dzervas/lab68/lab68.kicad_pcb

## KiCad design lab68.kicad_pcb (2020-12-09)

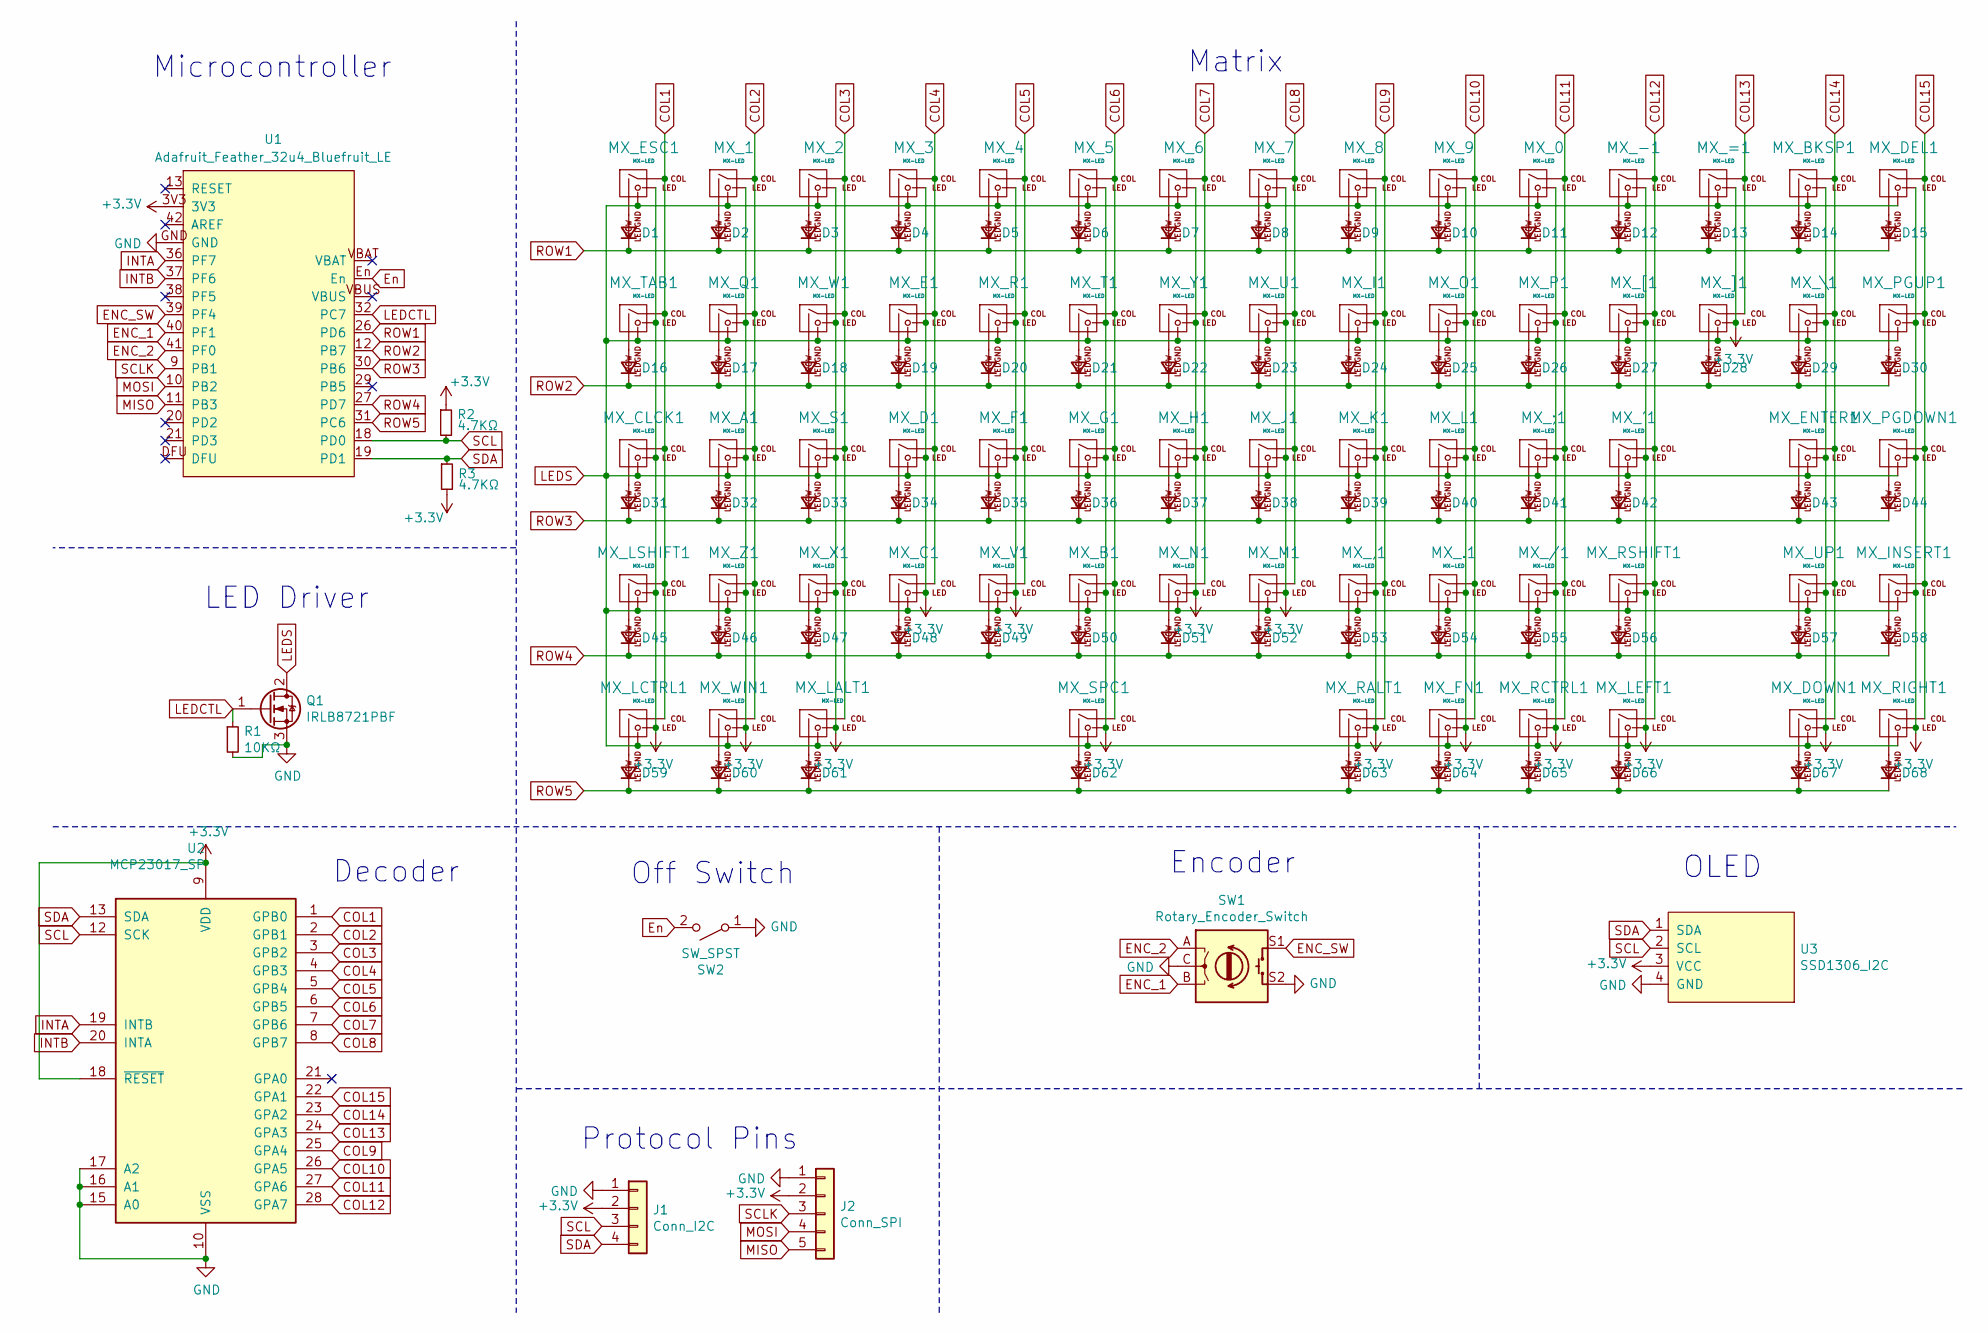
[picture p1: schematic lab68.sch]

Parts:
D1, D2, D3, D4, D5, D6, D7, D8, D9, D10, D11, D12, D13, D14, D15, D16, D17, D18, D19, D20, D21, D22, D23, D24, D25, D26, D27, D28, D29, D30, D31, D32, D33, D34, D35, D36, D37, D38, D39, D40, D41, D42, D43, D44, D45, D46, D47, D48, D49, D50, D51, D52, D53, D54, D55, D56, D57, D58, D59, D60, D61, D62, D63, D64, D65, D66, D67, D68: D_Small; D_DO-35_SOD27_P7.62mm_Horizontal
J1: Conn_I2C; JST_XH_B4B-XH-A_1x04_P2.50mm_Vertical
J2: Conn_SPI; JST_XH_B5B-XH-A_1x05_P2.50mm_Vertical
MX_0, MX_1, MX_2, MX_3, MX_4, MX_5, MX_6, MX_7, MX_8, MX_9, MX_.1: MX-LED; MXOnly-1U
MX_'1: MX-LED; MXOnly-1U
MX_,1: MX-LED; MXOnly-1U
MX_-1: MX-LED; MXOnly-1U
MX_/1: MX-LED; MXOnly-1U
MX_;1: MX-LED; MXOnly-1U
MX_=1: MX-LED; MXOnly-1U
MX_A1: MX-LED; MXOnly-1U
MX_B1: MX-LED; MXOnly-1U
MX_BKSP1: MX-LED; MXOnly-2U
MX_C1: MX-LED; MXOnly-1U
MX_CLCK1: MX-LED; MXOnly-1.75U
MX_D1: MX-LED; MXOnly-1U
MX_DEL1: MX-LED; MXOnly-1U
MX_DOWN1: MX-LED; MXOnly-1U
MX_E1: MX-LED; MXOnly-1U
MX_ENTER1: MX-LED; MXOnly-2.25U
MX_ESC1: MX-LED; MXOnly-1U
MX_F1: MX-LED; MXOnly-1U
MX_FN1: MX-LED; MXOnly-1U
MX_G1: MX-LED; MXOnly-1U
MX_H1: MX-LED; MXOnly-1U
MX_I1: MX-LED; MXOnly-1U
MX_INSERT1: MX-LED; MXOnly-1U
MX_J1: MX-LED; MXOnly-1U
MX_K1: MX-LED; MXOnly-1U
MX_L1: MX-LED; MXOnly-1U
MX_LALT1: MX-LED; MXOnly-1.25U
MX_LCTRL1: MX-LED; MXOnly-1.25U
MX_LEFT1: MX-LED; MXOnly-1U
MX_LSHIFT1: MX-LED; MXOnly-2.25U
MX_M1: MX-LED; MXOnly-1U
MX_N1: MX-LED; MXOnly-1U
MX_O1: MX-LED; MXOnly-1U
MX_P1: MX-LED; MXOnly-1U
MX_PGDOWN1: MX-LED; MXOnly-1U
MX_PGUP1: MX-LED; MXOnly-1U
MX_Q1: MX-LED; MXOnly-1U
MX_R1: MX-LED; MXOnly-1U
MX_RALT1: MX-LED; MXOnly-1U
MX_RCTRL1: MX-LED; MXOnly-1U
MX_RIGHT1: MX-LED; MXOnly-1U
MX_RSHIFT1: MX-LED; MXOnly-1.75U
MX_S1: MX-LED; MXOnly-1U
MX_SPC1: MX-LED; MXOnly-6.25U-ReversedStabilizers
MX_T1: MX-LED; MXOnly-1U
MX_TAB1: MX-LED; MXOnly-1.5U
MX_U1: MX-LED; MXOnly-1U
MX_UP1: MX-LED; MXOnly-1U
MX_V1: MX-LED; MXOnly-1U
MX_W1: MX-LED; MXOnly-1U
MX_WIN1: MX-LED; MXOnly-1.25U
MX_X1: MX-LED; MXOnly-1U
MX_Y1: MX-LED; MXOnly-1U
MX_Z1: MX-LED; MXOnly-1U
MX_[1: MX-LED; MXOnly-1U
MX_\1: MX-LED; MXOnly-1.5U
MX_]1: MX-LED; MXOnly-1U
Q1: IRLB8721PBF; TO-220-3_Horizontal_TabDown
R1: 10KΩ; R_Axial_DIN0207_L6.3mm_D2.5mm_P7.62mm_Horizontal
R2, R3: 4.7KΩ; R_Axial_DIN0207_L6.3mm_D2.5mm_P7.62mm_Horizontal
SW1: Rotary_Encoder_Switch; RotaryEncoder_Alps_EC11E-Switch_Vertical_H20mm
SW2: SW_SPST; SW_CuK_JS202011AQN_DPDT_Angled
U1: Adafruit_Feather_32u4_Bluefruit_LE
U2: MCP23017_SP; DIP-28_W7.62mm_Socket_LongPads
U3: SSD1306_I2C; OLED

Connections:
+3V3: J1.2, J2.2, MX_0.3 (LED), MX_1.3 (LED), MX_2.3 (LED), MX_3.3 (LED), MX_4.3 (LED), MX_5.3 (LED), MX_6.3 (LED), MX_7.3 (LED), MX_8.3 (LED), MX_9.3 (LED), MX_'1.3 (LED), MX_,1.3 (LED), MX_-1.3 (LED), MX_.1.3 (LED), MX_/1.3 (LED), MX_;1.3 (LED), MX_=1.3 (LED), MX_A1.3 (LED), MX_B1.3 (LED), MX_BKSP1.3 (LED), MX_C1.3 (LED), MX_CLCK1.3 (LED), MX_D1.3 (LED), MX_DEL1.3 (LED), MX_DOWN1.3 (LED), MX_E1.3 (LED), MX_ENTER1.3 (LED), MX_ESC1.3 (LED), MX_F1.3 (LED), MX_FN1.3 (LED), MX_G1.3 (LED), MX_H1.3 (LED), MX_I1.3 (LED), MX_INSERT1.3 (LED), MX_J1.3 (LED), MX_K1.3 (LED), MX_L1.3 (LED), MX_LALT1.3 (LED), MX_LCTRL1.3 (LED), MX_LEFT1.3 (LED), MX_LSHIFT1.3 (LED), MX_M1.3 (LED), MX_N1.3 (LED), MX_O1.3 (LED), MX_P1.3 (LED), MX_PGDOWN1.3 (LED), MX_PGUP1.3 (LED), MX_Q1.3 (LED), MX_R1.3 (LED), MX_RALT1.3 (LED), MX_RCTRL1.3 (LED), MX_RIGHT1.3 (LED), MX_RSHIFT1.3 (LED), MX_S1.3 (LED), MX_SPC1.3 (LED), MX_T1.3 (LED), MX_TAB1.3 (LED), MX_U1.3 (LED), MX_UP1.3 (LED), MX_V1.3 (LED), MX_W1.3 (LED), MX_WIN1.3 (LED), MX_X1.3 (LED), MX_Y1.3 (LED), MX_Z1.3 (LED), MX_[1.3 (LED), MX_\1.3 (LED), MX_]1.3 (LED), R2.1, R3.2, U1.3V3, U2.9 (VDD), U2.18 (~RESET~), U3.3 (VCC)
COL1: MX_CLCK1.1 (COL), MX_ESC1.1 (COL), MX_LCTRL1.1 (COL), MX_LSHIFT1.1 (COL), MX_TAB1.1 (COL), U2.1 (GPB0)
COL2: MX_1.1 (COL), MX_A1.1 (COL), MX_Q1.1 (COL), MX_WIN1.1 (COL), MX_Z1.1 (COL), U2.2 (GPB1)
COL3: MX_2.1 (COL), MX_LALT1.1 (COL), MX_S1.1 (COL), MX_W1.1 (COL), MX_X1.1 (COL), U2.3 (GPB2)
COL4: MX_3.1 (COL), MX_C1.1 (COL), MX_D1.1 (COL), MX_E1.1 (COL), U2.4 (GPB3)
COL5: MX_4.1 (COL), MX_F1.1 (COL), MX_R1.1 (COL), MX_V1.1 (COL), U2.5 (GPB4)
COL6: MX_5.1 (COL), MX_B1.1 (COL), MX_G1.1 (COL), MX_SPC1.1 (COL), MX_T1.1 (COL), U2.6 (GPB5)
COL7: MX_6.1 (COL), MX_H1.1 (COL), MX_N1.1 (COL), MX_Y1.1 (COL), U2.7 (GPB6)
COL8: MX_7.1 (COL), MX_J1.1 (COL), MX_M1.1 (COL), MX_U1.1 (COL), U2.8 (GPB7)
COL9: MX_8.1 (COL), MX_,1.1 (COL), MX_I1.1 (COL), MX_K1.1 (COL), MX_RALT1.1 (COL), U2.25 (GPA4)
COL10: MX_9.1 (COL), MX_.1.1 (COL), MX_FN1.1 (COL), MX_L1.1 (COL), MX_O1.1 (COL), U2.26 (GPA5)
COL11: MX_0.1 (COL), MX_/1.1 (COL), MX_;1.1 (COL), MX_P1.1 (COL), MX_RCTRL1.1 (COL), U2.27 (GPA6)
COL12: MX_'1.1 (COL), MX_-1.1 (COL), MX_LEFT1.1 (COL), MX_RSHIFT1.1 (COL), MX_[1.1 (COL), U2.28 (GPA7)
COL13: MX_=1.1 (COL), MX_]1.1 (COL), U2.24 (GPA3)
COL14: MX_BKSP1.1 (COL), MX_DOWN1.1 (COL), MX_ENTER1.1 (COL), MX_UP1.1 (COL), MX_\1.1 (COL), U2.23 (GPA2)
COL15: MX_DEL1.1 (COL), MX_INSERT1.1 (COL), MX_PGDOWN1.1 (COL), MX_PGUP1.1 (COL), MX_RIGHT1.1 (COL), U2.22 (GPA1)
ENC_1: SW1.B, U1.40 (PF1)
ENC_2: SW1.A, U1.41 (PF0)
ENC_SW: SW1.S1, U1.39 (PF4)
En: SW2.2 (B), U1.En
GND: J1.1, J2.1, Q1.3 (S), R1.2, SW1.C, SW1.S2, SW2.1 (A), U1.GND, U2.10 (VSS), U2.15 (A0), U2.16 (A1), U2.17 (A2), U3.4 (GND)
INTA: U1.36 (PF7), U2.19 (INTB)
INTB: U1.37 (PF6), U2.20 (INTA)
LEDCTL: Q1.1 (G), R1.1, U1.32 (PC7)
LEDS: MX_0.4 (LEDGND), MX_1.4 (LEDGND), MX_2.4 (LEDGND), MX_3.4 (LEDGND), MX_4.4 (LEDGND), MX_5.4 (LEDGND), MX_6.4 (LEDGND), MX_7.4 (LEDGND), MX_8.4 (LEDGND), MX_9.4 (LEDGND), MX_'1.4 (LEDGND), MX_,1.4 (LEDGND), MX_-1.4 (LEDGND), MX_.1.4 (LEDGND), MX_/1.4 (LEDGND), MX_;1.4 (LEDGND), MX_=1.4 (LEDGND), MX_A1.4 (LEDGND), MX_B1.4 (LEDGND), MX_BKSP1.4 (LEDGND), MX_C1.4 (LEDGND), MX_CLCK1.4 (LEDGND), MX_D1.4 (LEDGND), MX_DEL1.4 (LEDGND), MX_DOWN1.4 (LEDGND), MX_E1.4 (LEDGND), MX_ENTER1.4 (LEDGND), MX_ESC1.4 (LEDGND), MX_F1.4 (LEDGND), MX_FN1.4 (LEDGND), MX_G1.4 (LEDGND), MX_H1.4 (LEDGND), MX_I1.4 (LEDGND), MX_INSERT1.4 (LEDGND), MX_J1.4 (LEDGND), MX_K1.4 (LEDGND), MX_L1.4 (LEDGND), MX_LALT1.4 (LEDGND), MX_LCTRL1.4 (LEDGND), MX_LEFT1.4 (LEDGND), MX_LSHIFT1.4 (LEDGND), MX_M1.4 (LEDGND), MX_N1.4 (LEDGND), MX_O1.4 (LEDGND), MX_P1.4 (LEDGND), MX_PGDOWN1.4 (LEDGND), MX_PGUP1.4 (LEDGND), MX_Q1.4 (LEDGND), MX_R1.4 (LEDGND), MX_RALT1.4 (LEDGND), MX_RCTRL1.4 (LEDGND), MX_RIGHT1.4 (LEDGND), MX_RSHIFT1.4 (LEDGND), MX_S1.4 (LEDGND), MX_SPC1.4 (LEDGND), MX_T1.4 (LEDGND), MX_TAB1.4 (LEDGND), MX_U1.4 (LEDGND), MX_UP1.4 (LEDGND), MX_V1.4 (LEDGND), MX_W1.4 (LEDGND), MX_WIN1.4 (LEDGND), MX_X1.4 (LEDGND), MX_Y1.4 (LEDGND), MX_Z1.4 (LEDGND), MX_[1.4 (LEDGND), MX_\1.4 (LEDGND), MX_]1.4 (LEDGND), Q1.2 (D)
MISO: J2.5, U1.11 (PB3)
MOSI: J2.4, U1.10 (PB2)
unnamed: D1.2 (A), MX_ESC1.2 (ROW)
unnamed: D2.2 (A), MX_1.2 (ROW)
unnamed: D3.2 (A), MX_2.2 (ROW)
unnamed: D4.2 (A), MX_3.2 (ROW)
unnamed: D5.2 (A), MX_4.2 (ROW)
unnamed: D6.2 (A), MX_5.2 (ROW)
unnamed: D7.2 (A), MX_6.2 (ROW)
unnamed: D8.2 (A), MX_7.2 (ROW)
unnamed: D9.2 (A), MX_8.2 (ROW)
unnamed: D10.2 (A), MX_9.2 (ROW)
unnamed: D11.2 (A), MX_0.2 (ROW)
unnamed: D12.2 (A), MX_-1.2 (ROW)
unnamed: D13.2 (A), MX_=1.2 (ROW)
unnamed: D14.2 (A), MX_BKSP1.2 (ROW)
unnamed: D15.2 (A), MX_DEL1.2 (ROW)
unnamed: D16.2 (A), MX_TAB1.2 (ROW)
unnamed: D17.2 (A), MX_Q1.2 (ROW)
unnamed: D18.2 (A), MX_W1.2 (ROW)
unnamed: D19.2 (A), MX_E1.2 (ROW)
unnamed: D20.2 (A), MX_R1.2 (ROW)
unnamed: D21.2 (A), MX_T1.2 (ROW)
unnamed: D22.2 (A), MX_Y1.2 (ROW)
unnamed: D23.2 (A), MX_U1.2 (ROW)
unnamed: D24.2 (A), MX_I1.2 (ROW)
unnamed: D25.2 (A), MX_O1.2 (ROW)
unnamed: D26.2 (A), MX_P1.2 (ROW)
unnamed: D27.2 (A), MX_[1.2 (ROW)
unnamed: D28.2 (A), MX_]1.2 (ROW)
unnamed: D29.2 (A), MX_\1.2 (ROW)
unnamed: D30.2 (A), MX_PGUP1.2 (ROW)
unnamed: D31.2 (A), MX_CLCK1.2 (ROW)
unnamed: D32.2 (A), MX_A1.2 (ROW)
unnamed: D33.2 (A), MX_S1.2 (ROW)
unnamed: D34.2 (A), MX_D1.2 (ROW)
unnamed: D35.2 (A), MX_F1.2 (ROW)
unnamed: D36.2 (A), MX_G1.2 (ROW)
unnamed: D37.2 (A), MX_H1.2 (ROW)
unnamed: D38.2 (A), MX_J1.2 (ROW)
unnamed: D39.2 (A), MX_K1.2 (ROW)
unnamed: D40.2 (A), MX_L1.2 (ROW)
unnamed: D41.2 (A), MX_;1.2 (ROW)
unnamed: D42.2 (A), MX_'1.2 (ROW)
unnamed: D43.2 (A), MX_ENTER1.2 (ROW)
unnamed: D44.2 (A), MX_PGDOWN1.2 (ROW)
unnamed: D45.2 (A), MX_LSHIFT1.2 (ROW)
unnamed: D46.2 (A), MX_Z1.2 (ROW)
unnamed: D47.2 (A), MX_X1.2 (ROW)
unnamed: D48.2 (A), MX_C1.2 (ROW)
unnamed: D49.2 (A), MX_V1.2 (ROW)
unnamed: D50.2 (A), MX_B1.2 (ROW)
unnamed: D51.2 (A), MX_N1.2 (ROW)
unnamed: D52.2 (A), MX_M1.2 (ROW)
unnamed: D53.2 (A), MX_,1.2 (ROW)
unnamed: D54.2 (A), MX_.1.2 (ROW)
unnamed: D55.2 (A), MX_/1.2 (ROW)
unnamed: D56.2 (A), MX_RSHIFT1.2 (ROW)
unnamed: D57.2 (A), MX_UP1.2 (ROW)
unnamed: D58.2 (A), MX_INSERT1.2 (ROW)
unnamed: D59.2 (A), MX_LCTRL1.2 (ROW)
unnamed: D60.2 (A), MX_WIN1.2 (ROW)
unnamed: D61.2 (A), MX_LALT1.2 (ROW)
unnamed: D62.2 (A), MX_SPC1.2 (ROW)
unnamed: D63.2 (A), MX_RALT1.2 (ROW)
unnamed: D64.2 (A), MX_FN1.2 (ROW)
unnamed: D65.2 (A), MX_RCTRL1.2 (ROW)
unnamed: D66.2 (A), MX_LEFT1.2 (ROW)
unnamed: D67.2 (A), MX_DOWN1.2 (ROW)
unnamed: D68.2 (A), MX_RIGHT1.2 (ROW)
ROW1: D1.1 (K), D2.1 (K), D3.1 (K), D4.1 (K), D5.1 (K), D6.1 (K), D7.1 (K), D8.1 (K), D9.1 (K), D10.1 (K), D11.1 (K), D12.1 (K), D13.1 (K), D14.1 (K), D15.1 (K), U1.26 (PD6)
ROW2: D16.1 (K), D17.1 (K), D18.1 (K), D19.1 (K), D20.1 (K), D21.1 (K), D22.1 (K), D23.1 (K), D24.1 (K), D25.1 (K), D26.1 (K), D27.1 (K), D28.1 (K), D29.1 (K), D30.1 (K), U1.12 (PB7)
ROW3: D31.1 (K), D32.1 (K), D33.1 (K), D34.1 (K), D35.1 (K), D36.1 (K), D37.1 (K), D38.1 (K), D39.1 (K), D40.1 (K), D41.1 (K), D42.1 (K), D43.1 (K), D44.1 (K), U1.30 (PB6)
ROW4: D45.1 (K), D46.1 (K), D47.1 (K), D48.1 (K), D49.1 (K), D50.1 (K), D51.1 (K), D52.1 (K), D53.1 (K), D54.1 (K), D55.1 (K), D56.1 (K), D57.1 (K), D58.1 (K), U1.27 (PD7)
ROW5: D59.1 (K), D60.1 (K), D61.1 (K), D62.1 (K), D63.1 (K), D64.1 (K), D65.1 (K), D66.1 (K), D67.1 (K), D68.1 (K), U1.31 (PC6)
SCL: J1.3, R2.2, U1.18 (PD0), U2.12 (SCK), U3.2 (SCL)
SCLK: J2.3, U1.9 (PB1)
SDA: J1.4, R3.1, U1.19 (PD1), U2.13 (SDA), U3.1 (SDA)

Notes on the sheet:
Matrix
Decoder
Off Switch
Encoder
OLED
Protocol Pins
Microcontroller
LED Driver

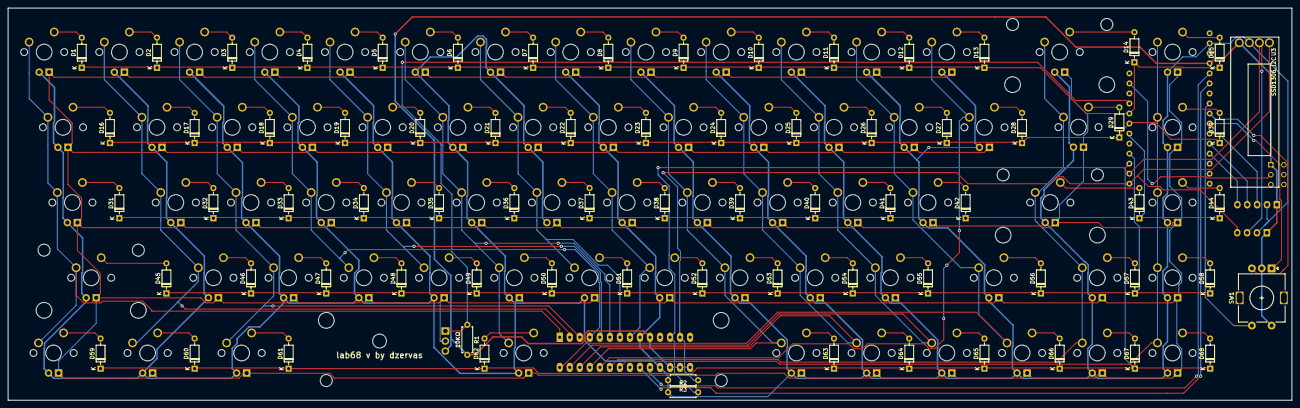
[picture p2: board lab68.kicad_pcb from above]

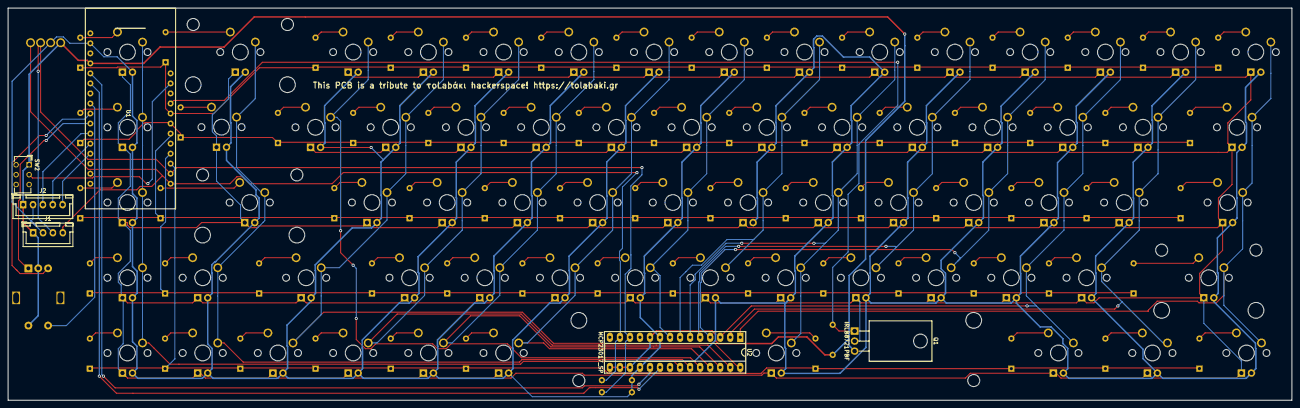
[picture p3: board lab68.kicad_pcb from below]

Board: 2 copper layers, 325.1 x 99.3 mm, 147 parts (6 on the bottom side), 103 nets.
