dzervas/lab68/PCB/Dissatisfaction65.kicad_pcb

## KiCad design PCB/Dissatisfaction65.kicad_pcb (2020-07-22)

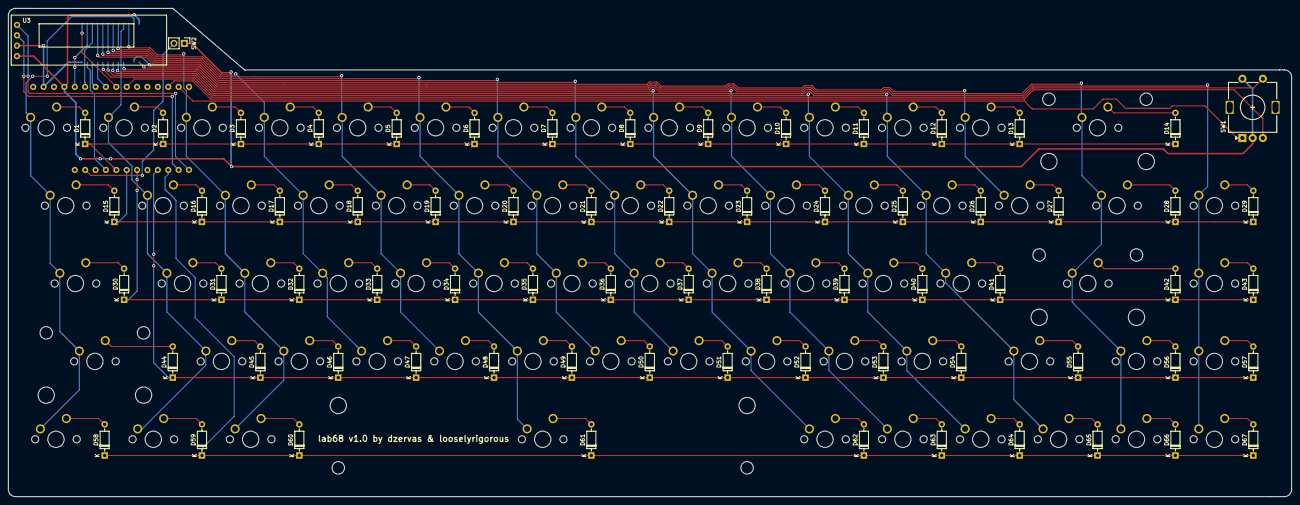
[picture p4: board Dissatisfaction65.kicad_pcb from above]

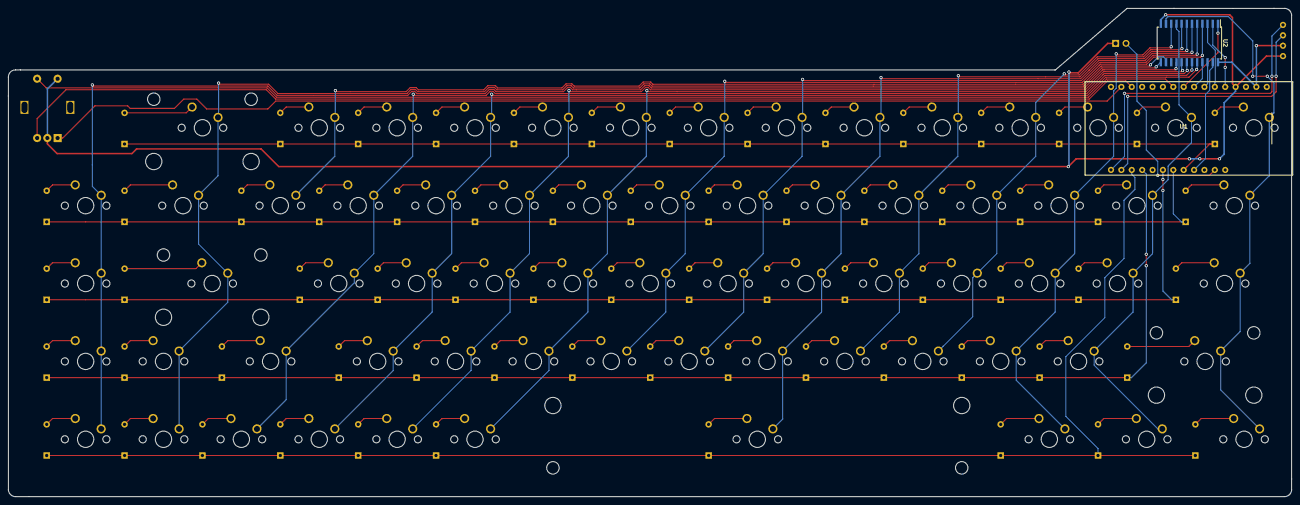
[picture p5: board Dissatisfaction65.kicad_pcb from below]

Board: 2 copper layers, 313.9 x 119.4 mm, 139 parts (2 on the bottom side), 101 nets.

Parts:
D1, D2, D3, D4, D5, D6, D7, D8, D9, D10, D11, D12, D13, D14, D15, D16, D17, D18, D19, D20, D21, D22, D23, D24, D25, D26, D27, D28, D29, D30, D31, D32, D33, D34, D35, D36, D37, D38, D39, D40, D41, D42, D43, D44, D45, D46, D47, D48, D49, D50, D51, D52, D53, D54, D55, D56, D57, D58, D59, D60, D61, D62, D63, D64, D65, D66, D67: D_Small; D_DO-35_SOD27_P7.62mm_Horizontal
MX_0, MX_1, MX_2, MX_3, MX_4, MX_5, MX_6, MX_7, MX_8, MX_9, MX_.1: MX-NoLED; MXOnly-1U-NoLED
MX_'1: MX-NoLED; MXOnly-1U-NoLED
MX_,1: MX-NoLED; MXOnly-1U-NoLED
MX_-1: MX-NoLED; MXOnly-1U-NoLED
MX_/1: MX-NoLED; MXOnly-1U-NoLED
MX_;1: MX-NoLED; MXOnly-1U-NoLED
MX_=1: MX-NoLED; MXOnly-1U-NoLED
MX_A1: MX-NoLED; MXOnly-1U-NoLED
MX_B1: MX-NoLED; MXOnly-1U-NoLED
MX_BKSP1: MX-NoLED; MXOnly-2U-NoLED
MX_C1: MX-NoLED; MXOnly-1U-NoLED
MX_CLCK1: MX-NoLED; MXOnly-1.75U-NoLED
MX_D1: MX-NoLED; MXOnly-1U-NoLED
MX_DEL1: MX-NoLED; MXOnly-1U-NoLED
MX_DOWN1: MX-NoLED; MXOnly-1U-NoLED
MX_E1: MX-NoLED; MXOnly-1U-NoLED
MX_END1: MX-NoLED; MXOnly-1U-NoLED
MX_ENTER1: MX-NoLED; MXOnly-2.25U-NoLED
MX_ESC1: MX-NoLED; MXOnly-1U-NoLED
MX_F1: MX-NoLED; MXOnly-1U-NoLED
MX_FN1: MX-NoLED; MXOnly-1U-NoLED
MX_G1: MX-NoLED; MXOnly-1U-NoLED
MX_H1: MX-NoLED; MXOnly-1U-NoLED
MX_HOME1: MX-NoLED; MXOnly-1U-NoLED
MX_I1: MX-NoLED; MXOnly-1U-NoLED
MX_J1: MX-NoLED; MXOnly-1U-NoLED
MX_K1: MX-NoLED; MXOnly-1U-NoLED
MX_L1: MX-NoLED; MXOnly-1U-NoLED
MX_LALT1: MX-NoLED; MXOnly-1.25U-NoLED
MX_LCTRL1: MX-NoLED; MXOnly-1.25U-NoLED
MX_LEFT1: MX-NoLED; MXOnly-1U-NoLED
MX_LSHIFT1: MX-NoLED; MXOnly-2.25U-NoLED
MX_M1: MX-NoLED; MXOnly-1U-NoLED
MX_N1: MX-NoLED; MXOnly-1U-NoLED
MX_O1: MX-NoLED; MXOnly-1U-NoLED
MX_P1: MX-NoLED; MXOnly-1U-NoLED
MX_Q1: MX-NoLED; MXOnly-1U-NoLED
MX_R1: MX-NoLED; MXOnly-1U-NoLED
MX_RALT1: MX-NoLED; MXOnly-1U-NoLED
MX_RCTRL1: MX-NoLED; MXOnly-1U-NoLED
MX_RIGHT1: MX-NoLED; MXOnly-1U-NoLED
MX_RSHIFT1: MX-NoLED; MXOnly-1.75U-NoLED
MX_S1: MX-NoLED; MXOnly-1U-NoLED
MX_SPC1: MX-NoLED; MXOnly-6.25U-ReversedStabilizers-NoLED
MX_T1: MX-NoLED; MXOnly-1U-NoLED
MX_TAB1: MX-NoLED; MXOnly-1.5U-NoLED
MX_U1: MX-NoLED; MXOnly-1U-NoLED
MX_UP1: MX-NoLED; MXOnly-1U-NoLED
MX_V1: MX-NoLED; MXOnly-1U-NoLED
MX_W1: MX-NoLED; MXOnly-1U-NoLED
MX_WIN1: MX-NoLED; MXOnly-1.25U-NoLED
MX_X1: MX-NoLED; MXOnly-1U-NoLED
MX_Y1: MX-NoLED; MXOnly-1U-NoLED
MX_Z1: MX-NoLED; MXOnly-1U-NoLED
MX_[1: MX-NoLED; MXOnly-1U-NoLED
MX_\1: MX-NoLED; MXOnly-1.5U-NoLED
MX_]1: MX-NoLED; MXOnly-1U-NoLED
SW1: Rotary_Encoder_Switch; RotaryEncoder_Alps_EC11E-Switch_Vertical_H20mm
SW2: SW_SPST; PinHeader_1x02_P2.54mm_Vertical
U1: Adafruit_Feather_32u4_Bluefruit_LE
U2: 74HC4514; SOIC-24W_7.5x15.4mm_P1.27mm
U3: SSD1306_I2C; OLED

Connections:
3v3: U1.3V3, U2.24, U3.3
CLD1: U1.36, U2.2
CLD2: U1.37, U2.3
CLD3: U1.39, U2.21
CLD4: U1.38, U2.22
COL1: MX_CLCK1.1, MX_ESC1.1, MX_LCTRL1.1, MX_LSHIFT1.1, MX_TAB1.1, U2.11
COL2: MX_1.1, MX_A1.1, MX_Q1.1, MX_WIN1.1, MX_Z1.1, U2.9
COL3: MX_2.1, MX_LALT1.1, MX_S1.1, MX_W1.1, MX_X1.1, U2.10
COL4: MX_3.1, MX_C1.1, MX_D1.1, MX_E1.1, U2.8
COL5: MX_4.1, MX_F1.1, MX_R1.1, MX_V1.1, U2.7
COL6: MX_5.1, MX_B1.1, MX_G1.1, MX_SPC1.1, MX_T1.1, U2.6
COL7: MX_6.1, MX_H1.1, MX_N1.1, MX_Y1.1, U2.5
COL8: MX_7.1, MX_J1.1, MX_M1.1, MX_U1.1, U2.4
COL9: MX_8.1, MX_,1.1, MX_I1.1, MX_K1.1, MX_RALT1.1, U2.18
COL10: MX_9.1, MX_.1.1, MX_FN1.1, MX_L1.1, MX_O1.1, U2.17
COL11: MX_0.1, MX_/1.1, MX_;1.1, MX_P1.1, MX_RCTRL1.1, U2.20
COL12: MX_'1.1, MX_-1.1, MX_LEFT1.1, MX_RSHIFT1.1, MX_[1.1, U2.19
COL13: MX_=1.1, MX_]1.1, U2.14
COL14: MX_BKSP1.1, MX_DOWN1.1, MX_ENTER1.1, MX_UP1.1, MX_\1.1, U2.13
COL15: MX_DEL1.1, MX_END1.1, MX_HOME1.1, MX_RIGHT1.1, U2.16
E: U1.32, U2.23
ENC_1: SW1.B, U1.20
ENC_2: SW1.A, U1.21
ENC_SW: SW1.S1, U1.41
En: SW2.2, U1.En
GND: SW1.C, SW1.S2, SW2.1, U1.GND, U2.12, U3.4
LE: U1.40, U2.1
unnamed: D1.2, MX_ESC1.2
unnamed: D2.2, MX_1.2
unnamed: D3.2, MX_2.2
unnamed: D4.2, MX_3.2
unnamed: D5.2, MX_4.2
unnamed: D6.2, MX_5.2
unnamed: D7.2, MX_6.2
unnamed: D8.2, MX_7.2
unnamed: D9.2, MX_8.2
unnamed: D10.2, MX_9.2
unnamed: D11.2, MX_0.2
unnamed: D12.2, MX_-1.2
unnamed: D13.2, MX_=1.2
unnamed: D14.2, MX_BKSP1.2
unnamed: D15.2, MX_TAB1.2
unnamed: D16.2, MX_Q1.2
unnamed: D17.2, MX_W1.2
unnamed: D18.2, MX_E1.2
unnamed: D19.2, MX_R1.2
unnamed: D20.2, MX_T1.2
unnamed: D21.2, MX_Y1.2
unnamed: D22.2, MX_U1.2
unnamed: D23.2, MX_I1.2
unnamed: D24.2, MX_O1.2
unnamed: D25.2, MX_P1.2
unnamed: D26.2, MX_[1.2
unnamed: D27.2, MX_]1.2
unnamed: D28.2, MX_\1.2
unnamed: D29.2, MX_DEL1.2
unnamed: D30.2, MX_CLCK1.2
unnamed: D31.2, MX_A1.2
unnamed: D32.2, MX_S1.2
unnamed: D33.2, MX_D1.2
unnamed: D34.2, MX_F1.2
unnamed: D35.2, MX_G1.2
unnamed: D36.2, MX_H1.2
unnamed: D37.2, MX_J1.2
unnamed: D38.2, MX_K1.2
unnamed: D39.2, MX_L1.2
unnamed: D40.2, MX_;1.2
unnamed: D41.2, MX_'1.2
unnamed: D42.2, MX_ENTER1.2
unnamed: D43.2, MX_HOME1.2
unnamed: D44.2, MX_LSHIFT1.2
unnamed: D45.2, MX_Z1.2
unnamed: D46.2, MX_X1.2
unnamed: D47.2, MX_C1.2
unnamed: D48.2, MX_V1.2
unnamed: D49.2, MX_B1.2
unnamed: D50.2, MX_N1.2
unnamed: D51.2, MX_M1.2
unnamed: D52.2, MX_,1.2
unnamed: D53.2, MX_.1.2
unnamed: D54.2, MX_/1.2
unnamed: D55.2, MX_RSHIFT1.2
unnamed: D56.2, MX_UP1.2
unnamed: D57.2, MX_END1.2
unnamed: D58.2, MX_LCTRL1.2
unnamed: D59.2, MX_WIN1.2
unnamed: D60.2, MX_LALT1.2
unnamed: D61.2, MX_SPC1.2
unnamed: D62.2, MX_RALT1.2
unnamed: D63.2, MX_FN1.2
unnamed: D64.2, MX_RCTRL1.2
unnamed: D65.2, MX_LEFT1.2
unnamed: D66.2, MX_DOWN1.2
unnamed: D67.2, MX_RIGHT1.2
ROW1: D1.1, D2.1, D3.1, D4.1, D5.1, D6.1, D7.1, D8.1, D9.1, D10.1, D11.1, D12.1, D13.1, D14.1, U1.26
ROW2: D15.1, D16.1, D17.1, D18.1, D19.1, D20.1, D21.1, D22.1, D23.1, D24.1, D25.1, D26.1, D27.1, D28.1, D29.1, U1.12
ROW3: D30.1, D31.1, D32.1, D33.1, D34.1, D35.1, D36.1, D37.1, D38.1, D39.1, D40.1, D41.1, D42.1, D43.1, U1.30
ROW4: D44.1, D45.1, D46.1, D47.1, D48.1, D49.1, D50.1, D51.1, D52.1, D53.1, D54.1, D55.1, D56.1, D57.1, U1.27
ROW5: D58.1, D59.1, D60.1, D61.1, D62.1, D63.1, D64.1, D65.1, D66.1, D67.1, U1.31
SCL: U1.18, U3.2
SDA: U1.19, U3.1
