dzervas/lab68/(threads)

Thread 1 (2020-09-21):

Bugs in version 1.1

dzervas, 2020-09-21:
The design was printed by JLCPCB and the following problems exist:

- [ ] I2C SDA/SCL lanes need 2 pull-up resistors 4.7KΩ (maybe we can use the internal pull-ups?)
- [ ] Connect the MCP interrupt lanes to the feather
- [ ] Feather & MCP footprint holes are not big enough the machined low profile female pin headers to come flush with the board
- [ ] The rotary encoder need 1mm margin to the right (so that even big knobs fit)
- [ ] Move to SPST angled switch for power
- [ ] Add native UART pinout
- [ ] Move UART & I2C pinouts closer
- [ ] Add pinout descriptions for feather, MCP, I2C, SPI, UART
- [ ] Switch footprint needs to have metal pads on both sides
- [ ] Add logos to silkscreen
- [ ] 2.4GHz module footprint (optional) nRF - 24L01?

The AWESOME things is that even with these stuff to be done, v1.1 is a success - it just needs 2 4.3K pull-up resistors on SDA & SCL. Both these and the 3v3 lane are broken out in a header conveniently
