dzervas/lab68/(commit log)

2020-07-22 Partially move to TADA68 layout - still figuring out what to do with the encoder and the screen
    [Dissatisfaction65.kicad_pcb]
2020-07-25 Rename the KiCad project
    [lab68.kicad_pcb, lab68.sch]
2020-07-26 Route the LED matrix, change to MCP23017 and add I2C & SPI connectors
    [lab68.kicad_pcb, lab68.sch]
2020-07-27 New schematic with global LED illumination - PCB not done yet
    [lab68.kicad_pcb, lab68.sch]
2020-07-27 PCB routed! YEY! Now someone has to proof check it
    [lab68.kicad_pcb, lab68.sch]
2020-07-27 Tiny fixes - mainly power symbols
    [lab68.kicad_pcb, lab68.sch]
2020-07-28 Squashed commit that rearages all the project
    Slight cleanup of the traces on the screen
    Moved feather 1 key right to avoid switch colliding with the feather
    pins on the front side
    Move SPI & I2C connectors to the back
    Updated the switche's footprint and placed it on the right side
    Chage the folder structure
    Change switch footprint to a small one
    [bottom_plate.dxf, combined_plates.dxf, lab68.kicad_pcb, lab68.sch, middle.dxf, switch_plate.dxf, top_plate.dxf]
2020-07-29 Move the MCP a bit to the left to avoid collision with stabilizers
    [lab68.kicad_pcb]
2020-07-29 Remove single pad nets
    [lab68.kicad_pcb, lab68.sch]
2020-07-29 Initial github action for new board version
2020-07-29 Fix a DRC error
    [lab68.kicad_pcb]
2020-07-29 Do not generate BOM on new release
2020-07-29 Combine ERC & DRC steps and combine the layers of the board on PDF
2020-07-30 Bump board version to 1.1
    [lab68.kicad_pcb]
2020-07-30 Fix board cuts to be closed loop and not angled
    [lab68.kicad_pcb]
2020-08-14 Fix MCP connection bug - only schematic
    [lab68.sch]
2020-09-01 Connect the MCP23017 address pins to ground
    [lab68.kicad_pcb]
2020-09-02 Move OLED a bit higher
    [lab68.kicad_pcb]
2020-09-11 Ignore HTML BOM files
2020-09-22 Move the rotary encoder to the right a bit
    [lab68.kicad_pcb]
2020-12-08 Fix the outline
    [lab68.kicad_pcb]
2020-12-08 Make OLED pads bigger, connect MCP interrupts
    [lab68.kicad_pcb, lab68.sch]
2020-12-08 Use kikit for CI
    [lab68.kicad_pcb]
2020-12-09 Create a zip of the gerbers
2020-12-09 Bump board version to
    [lab68.kicad_pcb]
